Softdrink117/esp-in-de/README.md

# ESP In. De.
 **ESP**2866 **In**put **De**vice  
エスピンデ  
*(ehsp-in-day)*

-----

## New Scope (c. Feb 10 2021)

This project describes a multi-function input intermediary for arcade cabinets that acts as a button remapper, autofire circuit, and input viewer for live streams.

### Currently Defined Features

- Support for 2L16B + Start + Coin
- Input viewer: animated web visualization that can be used as an OBS Browser Source for live streams
- Input remapper: arbitrary reassignment of buttons and lever to user preference
- Sideswap: allow a 1LxB control panel to be used as Player 1 or Player 2
  - Optional: Trigger sideswap from a button combination when Start is pressed
- Autofire:
  - Interval-based autofire
     - Input for X ticks, wait for Y ticks, repeat
  - Frequency-based autofire
     - Available as a fallback if sync is not connected
     - Implemented on a clock timer (if sync disconnected) or through dividing the vertical sync (EG: ~60Hz sync / 3 ≈ 20Hz auto, / 4 ≈ 15Hz auto, / 5 ≈ 12Hz auto, etc.)
- Configuration interface:
  - Available over the same web interface as the input display
  - Optional: onboard graphical hardware interface as well
     - Current theory: I2C OLED with persistence + rotary encoder with push switch

### Feature Requests

   - Profile support
     - Save a configuration to a profile and reload from the interface
   - On-the-fly profile swap
     - Change between configurations with a button press. Example per Kiwi:
     > For example, profile 1 has all the same settings as profile 2, but button D has 12hz A instead of 6hz A.  Then, a profile switch button could be bound to something such as player 2 start to swap between the two.  This way you could swap between the supershot rates of W and S in the middle of a run based on what powerup you collect.  I can think of some more practical and complex applications for this than just the D button, but either way it could be an interesting addition for complex setups and casual use alike.

   - Macros (multiple buttons triggered in sequence with one press)
     - Another example from Kiwi:

     ```
     Macro to reliably perform the Mushihimesama glitch
     Frame | 0 1 2
     - - - | - - -
     Btn A | 0 1 1
     Btn C | 1 1 0
     ```
   - Delays (before an interval - mostly meant as an 'if we can't do a macro, this can be used to do it manually' thing)
     - IE: When button pressed, wait for X frames before starting the interval, then repeat it as normal

### Decision Points

   - Physical design:
     - ~~Cabinet interstitial connectors / 'plug and play'~~
     - ~~Sync board~~
     - ~~Interconnect between sync board and main board~~
     - For now, decided on developing the JAMMA version first. Quick way to start, scalable to a variety of installs, and integrates sync handling (since JAMMA already contains video signals).
   - Supported features:
     - Onboard configuration adds complexity to the PCB design and programming, and web UI is sufficient for all main functions. But web UI is not always ideal. Plus, ability to set/view IP from the hardware would be great for multi-cabinet setups.
     - Requested features above - of particular note is the macro functionality, which is a value add but also complicates interface design.

## Inputs and Outputs

### Supported Inputs

One Joystick Lever and eight Button inputs per player are supported, with up to 5 buttons on the JAMMA edge and up to three buttons on a CPS2 Kick Harness compatible header. Between both players, a total of 2 Levers and 16 Buttons are supported.

All eight button inputs are considered separately by *ESP In. De.*, and are fully configurable and remappable.

### Supported Outputs

One Joystick Lever and eight Button outputs per player are supported, with up to 5 buttons on the JAMMA edge and up to three buttons on a Kick Harness connector. Between both players, a total of 2 Levers and 16 Buttons are supported.

**Note: while any input may be bound to any output, care must be taken when binding outputs. Some games do not respond well to a button signal being present on both the JAMMA edge and a kick harness.** As an example, CPS2 Street Fighter games seem to read both JAMMA button 4 and kick button 4 as the same input, meaning that some inputs will not register properly if both of them are connected.

### DIP Switches

Several DIP switches are available for configuration and quickly enabling/disabling different features. The DIPs control the following features (NOT FINALIZED):

| Switch | Name | Description |
| :----: | :--- | :--- |
| SW1 | Bypass Auto | A hardware switch to disable all 'autofire' input processing (autofire, macros, etc.). <br>It still allows remapping and sideswap to be used. |
| SW2 | Bypass Remap | A hardware switch to disable all remap (and duplication) features. <br>It still allows 'autofire' processing and sideswap to be used. |
| SW3 | Bypass Sideswap | A hardware switch to disable sideswap. <br>It still allows remap and 'autofire' processing to be used. |
| SW4 | | |
| SW5 | | |
| SW6 | | |

Combinations of switches can be used to create 'lockout' conditions quickly, for tournament play or to quickly revert to stock. For example, `SW1 ON`, `SW2 ON`, and `SW3 ON` together revert the cabinet to straight input passthrough, without any modifications.

## Circuit Design

High level diagram explaining overall topology. Power and other 'infrastructure' omitted for clarity.

```
[ ============================== CABINET ============================ ]
        |                                                     |
        |                                                     |
  Pullup resistor array (10kOhm)                              |
        |                                                     |
  PISO register(s)                                            |
        |                                                     |
[    SPI Input                    ]                           |
[                                 ]                           |
[               MCU           GPIO] --------------- [ Sync Processing ]
[                                 ]                           |
[   SPI Output                    ]                           |
        |                                                     |
  SIPO register(s)                                            |
        |                                                     |
  Open-collector/drain buffer/inverter                        |
        |                                                     |
[ ============================ GAME BOARD =========================== ]
```

### Sync Processing

Signal should be buffered (or inverted) before being processed. TTL level according to JAMMA spec, so should be pretty straightforward. The simplified topology of this sync processing circuit is shown below:

```
Game Bd
    |
    |--- Buffer --- RC Low-Pass --- GPIO
    |
Cabinet
```

This consists of an **RC circuit low-pass filter** (tuned around 200Hz) to pass only vertical sync pulses, then Schmitt trigger or software debounce.

Alternative options:
- ~~**LM1881** (or the similar LMH1980) sync ICs. Though designed for use with composite video, they have been proven to work with composite sync through JAMMA in other devices.~~
- Directly connect to the GPIO and simply use software sampling and filtering to evaluate, but this requires a high polling rate to ensure accuracy (ideally around 60kHz). Alternatively, an interrupt could be used. Per Hatsune Mike:
    > Could hook up TTL sync to an interrupt, and then in the ISR poll until half a line’s duration (0.5 x 1/15khz) and if it’s still asserted then chances are you’re in vblank. Then ignore sync pulses for the next ~8ms or so

    - As long as that ends up being <= sync pulse duration at 31kHz (which is theoretically 1/2 the pulse at 15kHz), that should be scalable to higher resolutions as well. Maybe would need to do `0.4 * 1/15kHz` or something to give a bit more buffer, but the basic theory seems sound.

## Variants

ESP In. De. as a concept is scalable to several different hardware implementations, for different applications:

- ***ESP In. De. JAMMA THT*** is a JAMMA-compliant interstitial device, designed to connect in between a game board (PCB, JVS I/O board, etc.) and an arcade cabinet wiring harness. It features JAMMA connectors on both sides, and is a fully integrated single-board solution.
  - As indicated in the name, this version uses through-hole components for ease of hand-assembly. This has the consequence of dramatically increasing PCB size and component costs, making it unsuitable for mass-production.
  - As of 2022/03/30, this is where primary development is taking place.
- ***ESP In. De. JAMMA SMD*** is a production-ready variant of the above, using surface mount components for ease of manufacturing and lower cost.
  - As of 2022/03/30, this version has not yet been started, but is in the late planning stages.
- ***ESP In. De. JVS*** is a concept for a variant of ESP In. De. that is specifically designed as a *cabinet* interstitial, for use in JVS-compliant arcade cabinets. Since JVS harness wiring upstream of the IO is not standardized between manufacturers, this variant may need additional adapter hardware (daughterboards or cable harness adapters) to be compatible with different cabinets.
  - As of 2022/03/30, this version has not yet been started.
- ***ESP In. De. Console*** is a concept for a variant of ESP In. De. that is specifically designed to interface with console arcade sticks. Many 3rd-party arcade stick PCBs have adopted a 20-pin standard for their input connections. It should be very possible to develop a variant that uses these connectors for input and output.
  - As of 2022/03/30, this version has not yet been started.

### BOM

Still WIP, not yet prototyped in hardware!!!

| Part &nbsp; &nbsp; &nbsp; &nbsp; &nbsp; &nbsp; &nbsp; &nbsp; &nbsp; &nbsp; &nbsp; &nbsp; &nbsp; &nbsp; &nbsp; &nbsp; &nbsp; &nbsp; &nbsp; | Quantity | Through-Hole &nbsp; &nbsp; &nbsp; &nbsp; &nbsp; &nbsp; &nbsp; &nbsp; | SMD |
| ---: | :---: | :--- | :--- |
| **Input and Output Logic** | | | |
| PISO Shift Register | 4 | [74HC165](https://www.digikey.com/en/products/detail/texas-instruments/CD74HC165E/475911) | [74LV165](https://www.digikey.com/en/products/detail/nexperia-usa-inc/74LV165D-118/1231120)
| SIPO Shift Register | 4 | [SN74AHC594N‎](https://www.digikey.com/en/products/detail/SN74AHC594N/296-33681-5-ND/1566900) | ~~[74LV594](https://www.digikey.com/en/products/detail/texas-instruments/SN74LV594ADR/1591586)~~<sup>1</sup>
| Open-Drain Inverter | 5 | [CD74AC05E](https://www.digikey.com/en/products/detail/texas-instruments/CD74AC05E/375662) | ~~[SN74LVC06AD](https://www.digikey.com/en/products/detail/texas-instruments/SN74LVC06AD/277342)~~<sup>1</sup>
| | | | |
| Open-Drain SIPO Register | 4 | ~~[TPIC6C596N](https://www.digikey.com/en/products/detail/texas-instruments/TPIC6C596N/378490)~~ | [NPIC6C596](https://www.digikey.com/en/products/detail/nexperia-usa-inc/NPIC6C596ADJ/4843269)<sup>1</sup> |
| **Sync Processing** | | | |
| Non-Inverting Buffer | 1 | ~~[SN74LV125A](https://www.digikey.com/en/products/detail/texas-instruments/SN74LV125AN/1594902)~~ | [SN74LVC1G34](https://www.digikey.com/en/products/detail/texas-instruments/SN74LVC1G34DBVR/738115)<sup>2</sup> |
| | | | |
| **User Interface** | | | |
| Rotary Encoder with Switch | 1 | [PEC12R-2217F-S0024](https://www.digikey.com/en/products/detail/bourns-inc/PEC12R-2217F-S0024/4499642) | N/A |
| | | | |
| **Passives** | | | |
| 8x10kOhm Bussed Resistor | 4 | [4609X-101-103LF](https://www.digikey.com/en/products/detail/4609X-101-103LF/4609X-101-103LF-ND/2634616) | [746X101103JP](https://www.digikey.com/en/products/detail/cts-resistor-products/746X101103JP/1118406)  |
| 0.1uF Capacitor | 17<sup>3</sup> | | |
| 0.01uF Capacitor | 2 | | |
| 10kOhm Resistor | 5 | | |
| 6.8kOhm Resistor | 1 | | |

<sup>1</sup>SMD version will utilize the NPIC6C596 instead of separate SIPO and buffer ICs; through-hole cannot use a similar part easily because of logic level mismatch.<br>
<sup>2</sup>Direct equivalent would be [SN74LVC125](https://www.digikey.com/en/products/detail/texas-instruments/SN74LVC125ADR/377413), but only one output is needed; 74LVC1G34 is a single-bit buffer in a compact package.<br>
<sup>3</sup>SMD version requires five fewer decoupling caps because it uses the NPIC6C596 for the functions of both the SIPO register and open-drain inverter of the THT version.

## Data Format

Inputs are ingested through shift registers, so it comes in as binary. Registers are usually available in 8 or 16-bit widths, which also aligns with some input formats neatly.

I propose the following bit layout:

```
2L16B + Start + Coin -> 28 bits (round up to 32, 4 extra for onboard hw)
-P1----- -------- -P2----- --------
UDLRS123 45678C00 UDLRS123 45678C00
```

I can stuff extra inputs into the remaining space, for DIP switches:
```
2L16B + Start + Coin -> 28 bits (round up to 32, 4 extra for onboard hw)
-P1----- -------- -P2----- --------
UDLRS123 45678Cij UDLRS123 45678Ckl

Where ijkl correspond to DIP switches 01-06
```

Ingest as binary means quick operations with bitmasks, eg:

```
Mask out DIPs   |  output = (input & 11111111 11111100 11111111 11111100)
Remap P1 to P2  |  output = (input >> 16)
Remap P2 to P1  |  output = (input << 16)
```

#### Onboard Interface Notes

Basic text/ASCII art based interface?

Idea: Can visualize button state with a pretty simple representation of `[XYZ]`, where `X` is the button identifier, `Y` is the auto mode, and `Z` is the rate/interval. For example:
```
[A]    [B]     [C] []
[Ar30] [Ai1-2] [B] []
```
The configuration above reads as follows:

- Physical Button A - Logical Button A
- Physical Button B - Logical Button B
- Physical Button C - Logical Button C
- Physical Button D - Logical Button A, 30Hz autofire (or whatever `roundToInt(sync/2)` is)
- Physical Button E - Logical Button A, 1-on 2-off interval
- Physical Button F - Logical Button B

Does this work or is it actually bad?

-----

### Installation instructions:

Required libraries:
- **ESP8266 Core Libraries** (installed via Board Manager)
- **ESP8266FS plugin** for Arduino IDE (https://github.com/esp8266/arduino-esp8266fs-plugin)
- **Arduino WebSockets Server and Client** from links2004 (https://github.com/Links2004/arduinoWebSockets) installed as a ZIP library in the IDE

To flash resources (html, css, etc.) to the SPI filesystem:
- Make sure *Tools>Flash Size* is greater than the combined size of entire sketch + data folder structure
- Make sure *Tools>Flash Size* is less than or equal to the size of the installed memory on the board
- Close serial monitor before upload
- Enter Program mode on ESP if necessary (some boards have auto-program)
- Ensure the ESP8266FS Tool is installed in Arduino Sketchbook>tools folder
- https://github.com/esp8266/arduino-esp8266fs-plugin
- Upload the data folder contents using *Tools>ESP8266 Data Upload*
- Upload the program data as normal from the Arduino IDE

-----

### Acknowledgements

This project would not have been possible without the help of the following people:

- [Hatsune Mike](https://github.com/Mikejmoffitt)
- [Thomas Daede](https://github.com/tdaede)
