Softdrink117/esp-in-de/kicad/ESP-In-De_JAMMA_THT/ESP-In-De_JAMMA_THT.kicad_pcb

## KiCad design hardware/displayPCB/displayPCB.sch

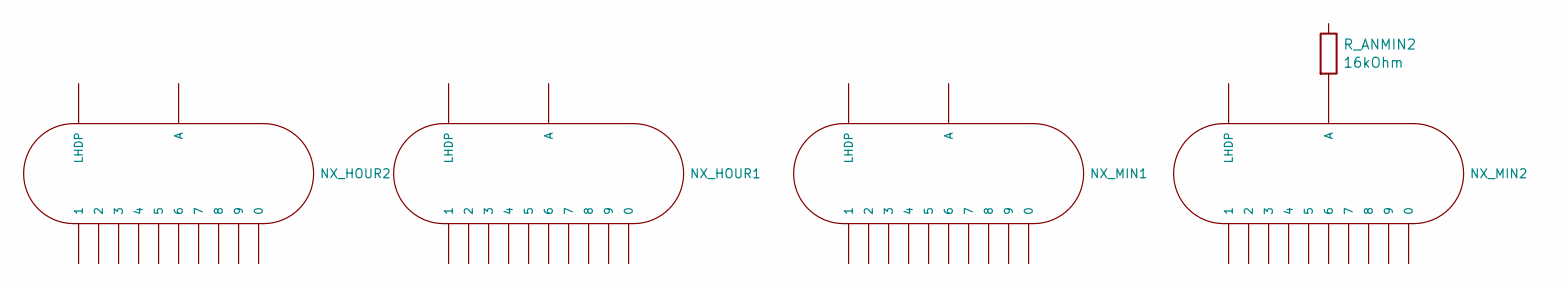
[picture p1: schematic displayPCB.sch]

Parts:
NX_HOUR1, NX_HOUR2: IN-12B; nixies-us_IN-12
NX_MIN1, NX_MIN2: IN-12B; nixies-us_IN-12
R_ANMIN2: 16kOhm

Connections:
unnamed: NX_MIN2.A, R_ANMIN2.2
