Softdrink117/esp-in-de/(commit log)

2021-02-02 Added JAMMA library, started KiCad project
    [ESP-In-De.kicad_pcb, ESP-In-De.sch]
2021-02-10 Minor changes
    [ESP-In-De.sch]
2021-02-10 Renamed kicad project to include JAMMA indication
    [ESP-In-De_JAMMA.kicad_pcb, ESP-In-De_JAMMA.sch]
2021-03-02 Actually made the darn schematic
    [ESP-In-De_ThroughHole.kicad_pcb, ESP-In-De_ThroughHole.sch]
2021-03-03 Updated schematic for throughhole version
2021-04-05 Schematic and Readme updates
    - Created through-hole schematic with most basic functionality implemented - still need to add sync and onboard buttons
    [ESP-In-De_ThroughHole.sch]
2022-03-22 Created JAMMA version, basic schematic
    [ESP-In-De_JAMMA.kicad_sch, ESP-In-De_JAMMA.sch]
2022-03-31 README updates, old desc, sch update Kick button labels, update JAMMAA symbol
    [ESP-In-De_JAMMA.kicad_sch]
2022-04-01 Readme updates, added Readme for Data Emulator, added symbol, updated schematic with sync circuit
    [ESP-In-De_JAMMA.kicad_sch]
2022-04-01 README adjustments for legibility; populated BOM
2022-04-01 Created JAMMA_THT project to disambiguate
    [ESP-In-De_JAMMA_THT.kicad_pcb, ESP-In-De_JAMMA_THT.kicad_sch, ESP-In-De_JAMMA_THT.sch]
2022-04-18 added Coin remapping
    [ESP-In-De_JAMMA_THT.kicad_sch]
2022-05-10 Adjusted Load label to show invert bar
    [ESP-In-De_JAMMA_THT.kicad_sch]
2022-06-03 Add kick connections, update encoder pullups
    [ESP-In-De_JAMMA_THT.kicad_sch]
2022-06-07 Minor tweak to sch
    [ESP-In-De_JAMMA_THT.kicad_sch]
